Diiliev/E-Bike_Memory_Seat_With_Serial/(commit log)

2022-05-17 Establish communication in one direction, from ROS Mobile through the action client and server and finally to the arduino.
2022-05-20 Implement buggy Full Duplex data transmission between the ROS Action Client <-> ROS Action Server <-> Microcontroller.
    [EbmsMicrocontrollerWithSerial.ino]
2022-05-20 Rename feedback.currentHeight to feedback.currentValue, because it stores both the seat height and status codes published by the arduino.
2022-05-23 Forbid the Action Client from sending new goals to the Action Server if the current one is not done executing.
2022-05-24 Forbid the Action Client from sending new goals until the current one has finished executing or the timer runs out. Incomming button presses are processed in real time.
2022-05-24 Forward cancel requests from the Action Client to the microcontroller. Stop the movement of the actuator when an action has been cancelled.
2022-05-27 Display cooldown time left on ROS Mobile. Add cooldown time publisher to arduino. Add cooldown time subscriber to Action Server and publish to log topic.
2022-06-09 Replace the test value of STALL_TIME with the more realistic 400ms.
    [EbmsMicrocontrollerWithSerial.ino]
2022-06-09 Begin implementing Raise/Lower buttons. Microcontroller nearly done, not tested. Action Client not done, not tested. Action Server not started.
2022-06-10 Fully Implement Raise/Lower buttons.
2022-06-11 Implement Action Client inside a class ClientListener. Fully implement all three memory buttons and two new Raise/Lower buttons to use the new Action Client.
2022-08-19 Set resting time for the actuator to 3 times the work time to ensure 25% duty cycle. It used to be 4 times which was 20% duty cycle. Improve documentation. Launch file change arduino port.
2022-08-22 BugFix: raise/lower manual buttons no longer cancel memory buttons. Also, ActionTimer was increased to 240s and a new line is logged after each action.
2023-01-18 Add project description to README. Add images for the Poster and Wiring Diagram.
